tomorrow56/SPRESENSE_ESP8266/kicad/SPRESENSE_MAIN_dimensional_drawing_20180516.pdf

## SPRESENSE MAIN

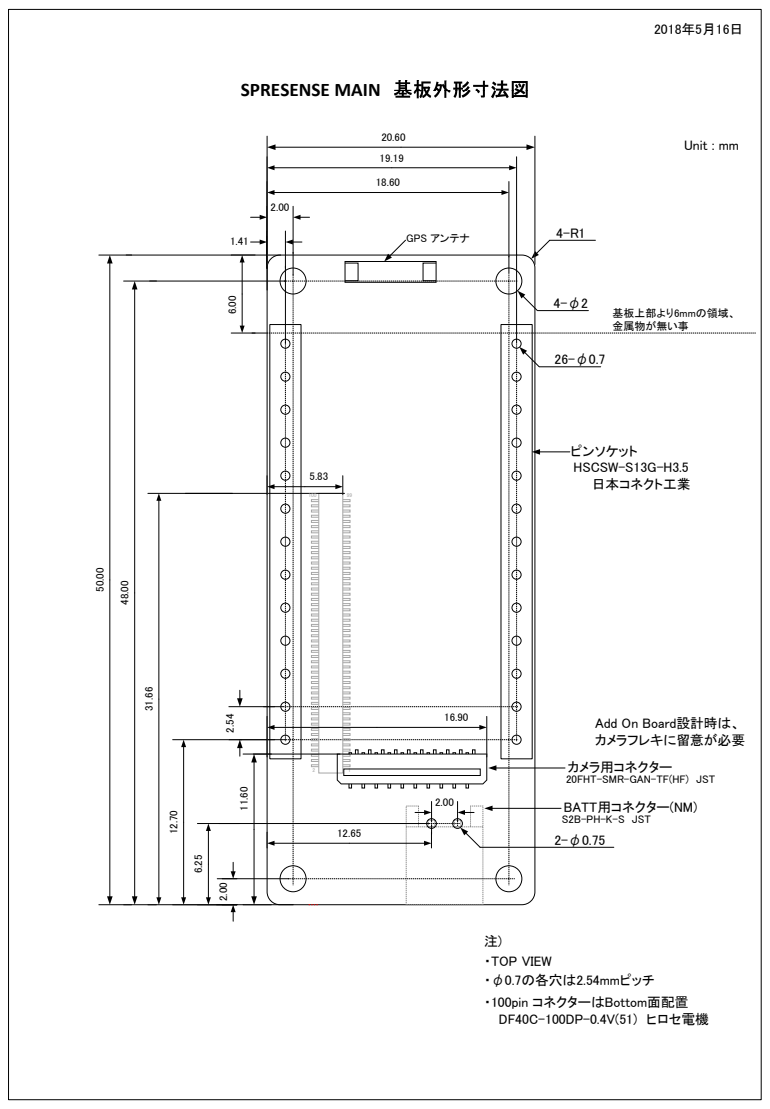
[picture p1: page 1]
・φ0.7の各穴は2.54mmピッチ; ・TOP VIEW; ・100pin コネクターはBottom面配置; Unit : mm; DF40C-100DP-0.4V(51) ヒロセ電機; BATT用コネクター(NM) S2B-PH-K-S JST; ピンソケット HSCSW-S13G-H3.5 日本コネクト工業; GPS アンテナ; 基板上部より6mmの領域、 金属物が無い事

Add On Board設計時は、
カメラフレキに留意が必要

カメラ用コネクター
20FHT-SMR-GAN-TF(HF) JST
