tomorrow56/SPRESENSE_ESP8266/kicad/v1.1/SPRESENSE_8266_v1r1_schema.pdf

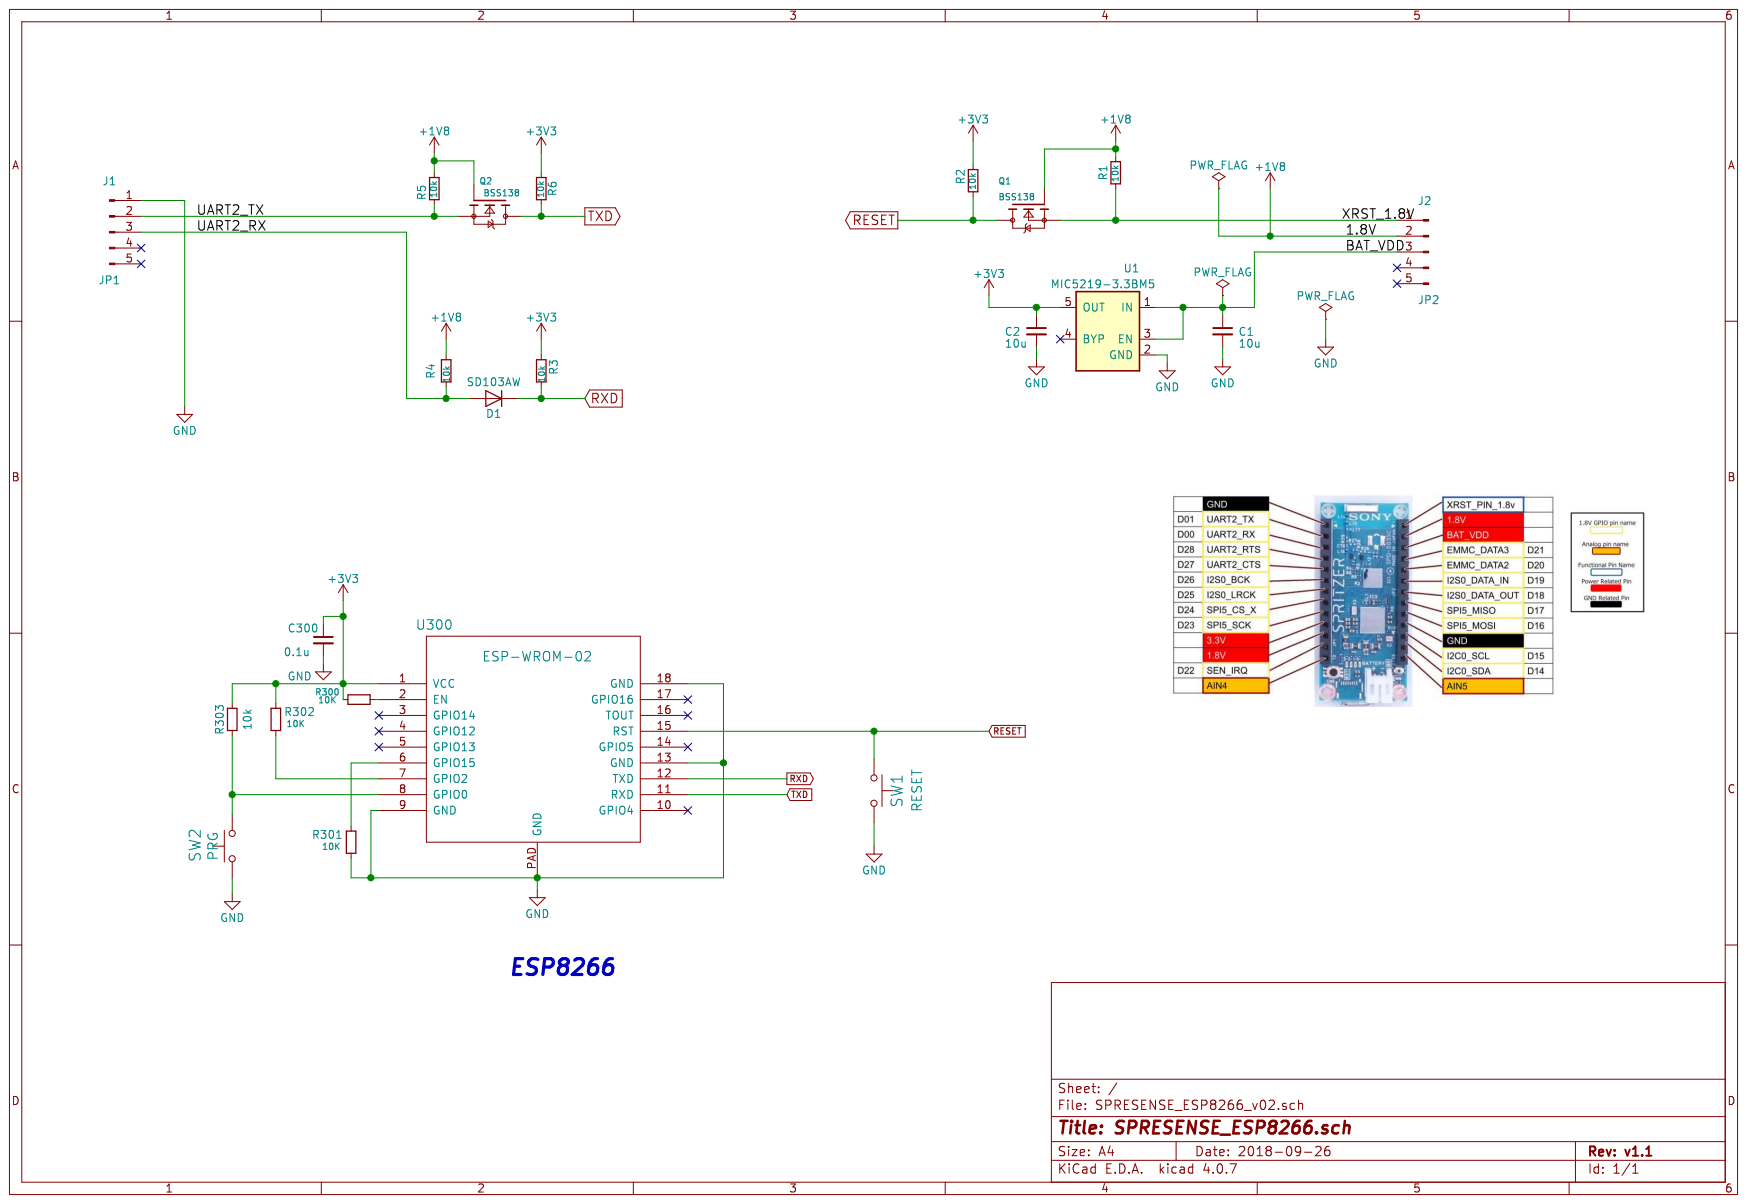
[picture p2: page 1]
