tomorrow56/SPRESENSE_ESP8266/kicad/v1.1/SPRESENSE_ESP8266_v02/SPRESENSE_ESP8266_v02.kicad_pcb

## KiCad design kicad/v1.1/SPRESENSE_ESP8266_v02/SPRESENSE_ESP8266_v02.kicad_pcb (2018-09-29)

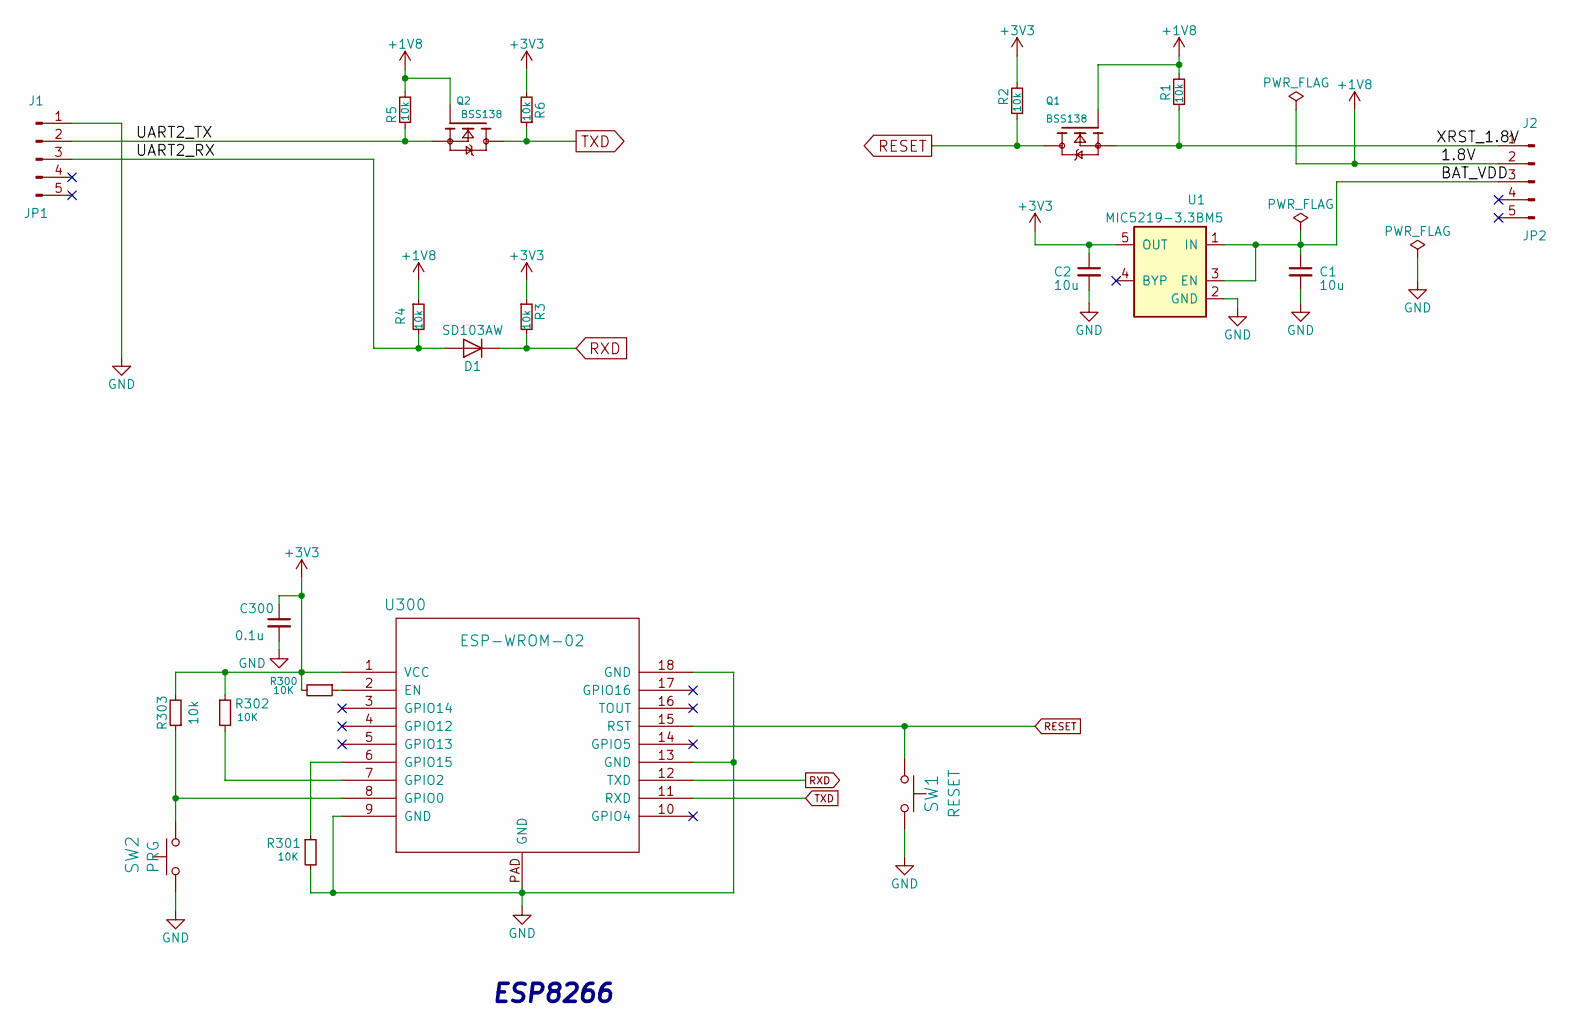
[picture p3: schematic SPRESENSE_ESP8266_v02.sch, SPRESENSE_ESP8266.sch]

Parts:
C1, C2: 10u; C_0603
C300: 0.1u; C_0603
D1: SD103AW; D_SOD-123
J1: JP1; Pin_Header_Straight_1x05_Pitch2.54mm_SMD_Pin1Right
J2: JP2; Pin_Header_Straight_1x05_Pitch2.54mm_SMD_Pin1Left
Q1, Q2: BSS138; SOT-23
R1, R2, R3, R4, R5, R6, R303: 10k; R_0603
R300, R301, R302: 10K; R_0603
SW1: RESET; SW_SPST_PTS810
SW2: PRG; SW_SPST_PTS810
U1: MIC5219-3.3BM5; SOT-23-5
U300: ESP-WROM-02; ESP-13-WROOM-02

Connections:
+1V8: J2.2, Q1.1 (G), Q2.1 (G), R1.2, R4.1, R5.2
+3V3: C2.1, C300.1, R2.2, R3.1, R6.2, R300.2, R302.1, R303.2, U1.5 (OUT), U300.1 (VCC)
/BAT_VDD: C1.1, J2.3, U1.1 (IN), U1.3 (EN)
/UART2_RX: D1.2 (A), J1.3, R4.2
/UART2_TX: J1.2, Q2.2 (S), R5.1
/XRST_1.8V: J2.1, Q1.2 (S), R1.1
GND: C1.2, C2.2, C300.2, J1.1, R301.2, SW1.1, SW2.1, U1.2 (GND), U300.9 (GND), U300.13 (GND), U300.18 (GND), U300.PAD (GND)
unnamed: R300.1, U300.2 (EN)
unnamed: R301.1, U300.6 (GPIO15)
unnamed: R302.2, U300.7 (GPIO2)
unnamed: R303.1, SW2.2, U300.8 (GPIO0)
RESET: Q1.3 (D), R2.1, SW1.2, U300.15 (RST)
RXD: D1.1 (K), R3.2, U300.12 (TXD)
TXD: Q2.3 (D), R6.1, U300.11 (RXD)

Notes on the sheet:
ESP8266

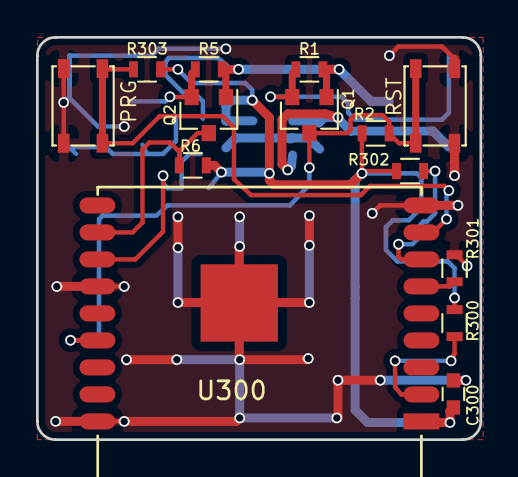
[picture p4: board SPRESENSE_ESP8266_v02.kicad_pcb from above]

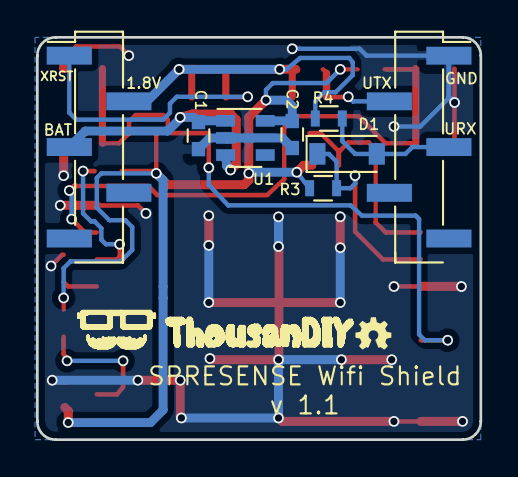
[picture p5: board SPRESENSE_ESP8266_v02.kicad_pcb from below]

Board: 2 copper layers, 24.6 x 22.4 mm, 23 parts (9 on the bottom side), 14 nets.

Other parts of the board:
ref**: val**; TDIY-LOGO-S
