tomorrow56/SPRESENSE_ESP8266/example/SPRESENSE_Sparkfun_ESP8266_Phant/SPRESENSE_Sparkfun_ESP8266_Phant.ino

/************************************************************
ESP8266_Phant.ino
SparkFun ESP8266 AT library - Phant Posting Example
Jim Lindblom @ SparkFun Electronics
Original Creation Date: July 16, 2015
https://github.com/sparkfun/SparkFun_ESP8266_AT_Arduino_Library

This example demonstrates how to use the TCP client
functionality of the SparkFun ESP8266 WiFi library to post
sensor readings to a Phant stream on
https://data.sparkfun.com

This sketch is set up to post to a publicly available stream
https://data.sparkfun.com/streams/DJjNowwjgxFR9ogvr45Q
Please don't abuse it! But feel free to post a few times to
verify the sketch works. If it fails, check the HTTP response
to make sure the post rate hasn't been exceeded.

Development environment specifics:
  IDE: Arduino 1.6.5
  Hardware Platform: Arduino Uno
  ESP8266 WiFi Shield Version: 1.0

This code is beerware; if you see me (or any other SparkFun
employee) at the local, and you've found our code helpful,
please buy us a round!

Distributed as-is; no warranty is given.
************************************************************/
// The SparkFunESP8266WiFi library uses SoftwareSerial
// to communicate with the ESP8266 module. Include that
// library first:
// #include <SoftwareSerial.h>
// Include the ESP8266 AT library:
#include <SparkFunESP8266WiFi.h>

//////////////////////////////
// WiFi Network Definitions //
//////////////////////////////
// Replace these two character strings with the name and
// password of your WiFi network.
const char mySSID[] = "SSID";
const char myPSK[] = "PASSWD";

/////////////////////
// Phant Constants //
/////////////////////
// Phant detsination server:
const String phantServer = "data.sparkfun.com";
// Phant public key:
const String publicKey = "DJjNowwjgxFR9ogvr45Q";
// Phant private key:
const String privateKey = "P4eKwGGek5tJVz9Ar84n";
String httpHeader = "POST /input/" + publicKey + ".txt HTTP/1.1\n" +
                    "Host: " + phantServer + "\n" +
                    "Phant-Private-Key: " + privateKey + "\n" +
                    "Connection: close\n" +
                    "Content-Type: application/x-www-form-urlencoded\n";

void setup()
{
  int status;
  Serial.begin(115200);

  // To turn the MG2639 shield on, and verify communication
  // always begin a sketch by calling cell.begin().
  status = esp8266.begin(115200);
  if (status <= 0)
  {
    Serial.println(F("Unable to communicate with shield. Looping"));
    while(1) ;
  }

  esp8266.setMode(ESP8266_MODE_STA); // Set WiFi mode to station
  if (esp8266.status() <= 0) // If we're not already connected
  {
    if (esp8266.connect(mySSID, myPSK) < 0)
    {
      Serial.println(F("Error connecting"));
      while (1) ;
    }
  }

  // Get our assigned IP address and print it:
  Serial.print(F("My IP address is: "));
  Serial.println(esp8266.localIP());

  Serial.println(F("Press any key to post to Phant!"));
}

void loop()
{
  // If a character has been received over serial:
  if (Serial.available())
  {
    // !!! Make sure we haven't posted recently
    // Post to Phant!
    postToPhant();
    // Then clear the serial buffer:
    while (Serial.available())
      Serial.read();
  }
}

void postToPhant()
{
  // Create a client, and initiate a connection
  ESP8266Client client;

  if (client.connect(phantServer, 80) <= 0)
  {
    Serial.println(F("Failed to connect to server."));
    return;
  }
  Serial.println(F("Connected."));

  // Set up our Phant post parameters:
  String params;
  params += "analog0=" + String(analogRead(A0)) + "&";
  params += "analog1=" + String(analogRead(A1)) + "&";
  params += "analog2=" + String(analogRead(A2)) + "&";
  params += "analog3=" + String(analogRead(A3)) + "&";
  params += "analog4=" + String(analogRead(A4)) + "&";
  params += "analog5=" + String(analogRead(A5));

  Serial.println(F("Posting to Phant!"));

  client.print(httpHeader);
  client.print("Content-Length: "); client.println(params.length());
  client.println();
  client.print(params);

  // available() will return the number of characters
  // currently in the receive buffer.
  while (client.available())
    Serial.write(client.read()); // read() gets the FIFO char

  // connected() is a boolean return value - 1 if the
  // connection is active, 0 if it's closed.
  if (client.connected())
    client.stop(); // stop() closes a TCP connection.
}
