tomorrow56/SPRESENSE_ESP8266/(commit log)

2018-09-27 Add sample projects
2018-09-29 add kicad data
    [SPRESENSE_ESP8266_v02-B.Cu.gbl, SPRESENSE_ESP8266_v02-B.Mask.gbs, SPRESENSE_ESP8266_v02-B.SilkS.gbo, SPRESENSE_ESP8266_v02-Edge.Cuts.gm1, SPRESENSE_ESP8266_v02-F.Cu.gtl, SPRESENSE_ESP8266_v02-F.Mask.gts, SPRESENSE_ESP8266_v02-F.SilkS.gto, SPRESENSE_ESP8266_v02.drl]
2018-09-29 bug fix: ESP_GETpage()
    ESP_GETpage() return false and replybuffer is not valid.
    replybuffer size is not enough to get page.
    [SPRESENSE_ESP8266.ino]
